robherc/Thermocouple_Board/README.md

# Thermocouple_Board
Ultra-fast, Ultra-Precise Thermocouple reading board with SPI and Analog outputs
