robherc/Thermocouple_Board/BOM/ThermocoupleBoard_BOM_1.1.xlsx

Source: | /home/robherc/Projects/RotoForge/Isolated Thermocouple Board/ThermocoupleBoard1.1/ThermocoupleBoard1.1.kicad_sch
Date: | Fri 17 Jan 2025 01:48:11 AM EST
Tool: | Eeschema 7.0.11+dfsg-1build4
Generator: | /usr/share/kicad/plugins/bom_csv_grouped_by_value_with_fp.py
Component Count: | 85
Ref | Qnty | Value | Cmp name | Footprint | Description | Part # | Vendor | Link
C1, C2 | 2 | 10u | C | Capacitor_SMD:C_0805_2012Metric | Ceramic capacitor | 1276-1096-1-ND | DigiKey | https://www.digikey.com/en/products/detail/samsung-electro-mechanics/CL21A106KOQNNNE/3886754
C3, C4 | 2 | 2u2 | C | Capacitor_SMD:C_0603_1608Metric | Ceramic capacitor | 1276-1040-1-ND | DigiKey | https://www.digikey.com/en/products/detail/samsung-electro-mechanics/CL10A225KO8NNNC/3886698
C5, C7, C9, C11, C14, C15, C16, C18, C20, C21, C23, C25, C27, C29 | 14 | 1u | C | Capacitor_SMD:C_0402_1005Metric | Ceramic capacitor | 1276-1076-1-ND | DigiKey | https://www.digikey.com/en/products/detail/samsung-electro-mechanics/CL05A105KP5NNNC/3886734
C6, C8, C10, C12, C17, C19, C22, C24, C26, C28, C30, C34 | 12 | 10n | C | Capacitor_SMD:C_0402_1005Metric | Ceramic capacitor | 490-1313-1-ND | DigiKey | https://www.digikey.com/en/products/detail/murata-electronics/GRM155R71C103KA01D/587215
C13, C35, C36 | 3 | 0u1 | C | Capacitor_SMD:C_0402_1005Metric | Ceramic capacitor | 490-6328-1-ND | DigiKey | https://www.digikey.com/en/products/detail/murata-electronics/GRM155R71C104KA88J/2610892
C33 | 1 | 0.47u | C | Capacitor_SMD:C_0402_1005Metric | Ceramic capacitor | 490-3264-1-ND | DigiKey | https://www.digikey.com/en/products/detail/murata-electronics/GRM155R61A474KE15D/702528
D1 | 1 | D_Schottky | D_Schottky | Diode_SMD:D_2010_5025Metric | Schottky barrier diode | 4878-SK14CT-ND | DigiKey | https://www.digikey.com/en/products/detail/diotec-semiconductor/SK14/13164091
D2 | 1 | D_Zener_3v0 | D_Zener | Diode_SMD:D_SOD-123 | Zener diode 3V0 | MMSZ4683-TPMSCT-ND | DigiKey | https://www.digikey.com/en/products/detail/micro-commercial-co/MMSZ4683-TP/2345537
J1 | 1 | DAC_OUT | Conn_01x01 | PinHeader_1x01_P2.54mm_Vertical | Single Header Pin | SAM1112-01-ND | DigiKey | https://www.digikey.com/en/products/detail/samtec-inc/TS-101-T-A/1105493
J2 | 1 | SPI | Conn_01x06 | PinHeader_1x06_P2.54mm_Vertical | 2.54mm 6-pin header | SAM1112-06-ND | DigiKey | https://www.digikey.com/en/products/detail/samtec-inc/TS-106-T-A/1105488
J3 | 1 | RST | Conn_01x02 | PinHeader_1x02_P2.54mm_Vertical | 2.54mm 2-pin header | SAM1112-02-ND | DigiKey | https://www.digikey.com/en/products/detail/samtec-inc/TS-102-T-A/1105492
J4 | 1 | DAC | Conn_01x03 | PinHeader_1x03_P2.54mm_Vertical | 2.54mm 3-pin header | SAM1112-03-ND | DigiKey | https://www.digikey.com/en/products/detail/samtec-inc/TS-103-T-A/1105491
J5 | 1 | SWD | Conn_01x04 | PinHeader_1x04_P2.54mm_Vertical | 2.54mm 4-pin header | SAM1112-04-ND | DigiKey | https://www.digikey.com/en/products/detail/samtec-inc/TS-104-T-A/1105490
J6 | 1 | UPDI | Conn_01x03 | PinHeader_1x03_P2.54mm_Vertical | 2.54mm 3-pin header | SAM1112-03-ND | DigiKey | https://www.digikey.com/en/products/detail/samtec-inc/TS-103-T-A/1105491
L1 | 1 | SRF0703-6R8M | SRF0703-220M | custom:0703 | 6.8uH SMPS dual-coil inductor/xfmr | SRF0703-6R8MCT-ND | DigiKey | https://www.digikey.com/en/products/detail/bourns-inc/SRF0703-6R8M/2458495
Q1 | 1 | DMN2310U | DMG2301L | Package_TO_SOT_SMD:SOT-23 | MOSFET BVDSS: 8V~24V SOT23 | 31-DMN2310U-7CT-ND | DigiKey | https://www.digikey.com/en/products/detail/diodes-incorporated/DMN2310U-7/16547521
R1 | 1 | 4R7 | R | Resistor_SMD:R_2512_6332Metric | Resistor | CR2512-J/-4R7ELF | DigiKey | https://www.digikey.com/en/products/detail/bourns-inc/CR2512-J-4R7ELF/3785984
R2 | 1 | 470R | R | Resistor_SMD:R_0402_1005Metric | Resistor | RC0402FR-07470RL | DigiKey | https://www.digikey.com/en/products/detail/yageo/RC0402FR-07470RL/726619
R3 | 1 | 10R | R | Resistor_SMD:R_1206_3216Metric | Resistor | WR12X100 JTL | DigiKey | https://www.digikey.com/en/products/detail/walsin-technology-corporation/WR12X100-JTL/13240676
R4, R5, R10, R11, R12, R13 | 6 | 1k | R | Resistor_SMD:R_0603_1608Metric | Resistor | RC0603DR-071KL | DigiKey | https://www.digikey.com/en/products/detail/yageo/RC0603DR-071KL/5917907
R6, R14, R17 | 3 | 22k | R | Resistor_SMD:R_0603_1608Metric | Resistor | RT0603DRE0722KL | DigiKey | https://www.digikey.com/en/products/detail/yageo/RT0603DRE0722KL/1074702
R7 | 1 | 470k | R | Resistor_SMD:R_0603_1608Metric | Resistor | RT0603DRE07470KL | DigiKey | https://www.digikey.com/en/products/detail/yageo/RT0603DRE07470KL/5928918
R8, R9 | 2 | 47k | R | Resistor_SMD:R_0603_1608Metric | Resistor | RC0603DR-0747KL | DigiKey | https://www.digikey.com/en/products/detail/yageo/RC0603DR-0747KL/5918084
R15, R16 | 2 | 1M | R | Resistor_SMD:R_0603_1608Metric | Resistor | 560112116074 | DigiKey | https://www.digikey.com/en/products/detail/w%C3%BCrth-elektronik/560112116074/22230634
R19 | 1 | 0R | R | Resistor_SMD:R_1206_3216Metric | Resistor | RMCF1206ZT0R00 | DigiKey | https://www.digikey.com/en/products/detail/stackpole-electronics-inc/RMCF1206ZT0R00/1756906
R20 | 1 | 10M | R | Resistor_SMD:R_0402_1005Metric | Resistor | AC0402JR-0710ML | DigiKey | https://www.digikey.com/en/products/detail/yageo/AC0402JR-0710ML/5895572
R21, R22 | 2 | 10K | R | Resistor_SMD:R_0603_1608Metric | Resistor | 560112116005 | DigiKey | https://www.digikey.com/en/products/detail/w%C3%BCrth-elektronik/560112116005/22230720
RV1 | 1 | Trim-Pot_20k | R_Potentiometer_US | custom:TRIM_TC33X-2-203E | 20k Trim-Pot | TC33X-2-203ECT-ND | DigiKey | https://www.digikey.com/en/products/detail/bourns-inc/TC33X-2-203E/2566887
RX1 | 1 | 1M | R | Resistor_SMD:R_0603_1608Metric | Resistor | 560112116074 | DigiKey | https://www.digikey.com/en/products/detail/w%C3%BCrth-elektronik/560112116074/22230634
RY1 | 1 | 1M | R | Resistor_SMD:R_0603_1608Metric | Resistor | 560112116074 | DigiKey | https://www.digikey.com/en/products/detail/w%C3%BCrth-elektronik/560112116074/22230634
Rz1, Rz2, Rz3 | 3 | 22k | R | Resistor_SMD:R_0603_1608Metric | Resistor | 560112116022 | DigiKey | https://www.digikey.com/en/products/detail/w%C3%BCrth-elektronik/560112116022/22230630
TC1 | 1 | Thermocouple | Thermocouple | custom:TypeKSocket | Thermocouple Socket | PCC-SMP-U | AliExpress | https://www.aliexpress.us/item/3256805330271859.html
TVS1 | 1 | 256V | D_TVS | custom:DO-214AA | Bidirectional TVS diode | 13-P6SMB300CA-AT/TR13CT-ND | DigiKey | https://www.digikey.com/en/products/detail/yageo/P6SMB300CA-AT-TR13/16266113
U1 | 1 | MSPM0G1507SPTR | MSPM0G1507SPTR | Package_QFP:LQFP-48_7x7mm_P0.5mm | 80MHz 32-bit ARM Mixed-Signal MCU | MSPM0G1507SPTR | DigiKey | https://www.digikey.com/en/products/detail/texas-instruments/MSPM0G1507SPTR/22147190
U2 | 1 | ATtiny1604-SS | ATtiny1604-SS | Package_SO:SOIC-14_3.9x8.7mm_P1.27mm | AtTiny1604 – 20MHz, SOIC-14 | ATTINY1604-SSNR | DigiKey | https://www.digikey.com/en/products/detail/microchip-technology/ATTINY1604-SSNR/10270297
U3 | 1 | H11L1 | H11L1 | custom:H11L1-4 | SMPS control feedback OptoIsolator | H11L1SM | DigiKey | https://www.digikey.com/en/products/detail/isocom-components-2004-ltd/H11L1SM/5036962
U4, U5 | 2 | AP2112K-3.3 | AP2112K-3.3 | Package_TO_SOT_SMD:SOT-23-5 | 600mA LDO, 3.8V-6V in, 3.3V out | AP2112K-3.3TRG1 | DigiKey | https://www.digikey.com/en/products/detail/diodes-incorporated/AP2112K-3-3TRG1/4470746
U6 | 1 | TSZ121 | TSZ121ICT | Package_TO_SOT_SMD:SOT-353_SC-70-5 | IC OPAMP ZERO DRIFT | TSZ121ICT | DigiKey | https://www.digikey.com/en/products/detail/stmicroelectronics/TSZ121ICT/3820959
U7 | 1 | MCP1501T-20E | MCP1501-10xCH | Package_TO_SOT_SMD:SOT-23-6 | 2.048V, 0.1%, 20mA, Precision Vref | MCP1501T-20E/CHY | DigiKey | https://www.digikey.com/en/products/detail/microchip-technology/MCP1501T-20E-CHY/5844606
U8 | 1 | MCP3565R | MCP3565R | custom:MCP3565 | SPI ADC 24-bit | MCP3565RT-E/SFX | DigiKey | https://www.digikey.com/en/products/detail/microchip-technology/MCP3565RT-E-SFX/13252217
U9 | 1 | ISO1640BDR | ISO6721RB | Package_SO:SOIC-8_3.9x4.9mm_P1.27mm | Bi-Directional Digital Isolator, 1.7MHz | ISO1640BDR | DigiKey | https://www.digikey.com/en/products/detail/texas-instruments/ISO1640BDR/13627078
U11 | 1 | STS40-CD1B | STS4X | custom:STS4X | I2C Temperature Sensor | STS40-CD1B-R3 | DigiKey | https://www.digikey.com/en/products/detail/sensirion-ag/STS40-CD1B-R3/16021180
JP1 | 2 | Shorting Jumper | Shorting Jumper | N/A | 2.54mm Header-pins Jumper | QPC02SXGN-RC | DigiKey | https://www.digikey.com/en/products/detail/sullins-connector-solutions/QPC02SXGN-RC/2618262
