robherc/Thermocouple_Board/PCB/Thermocouple_Board.kicad_pcb

## KiCad design PCB/Thermocouple_Board.kicad_pcb (2025-03-31)

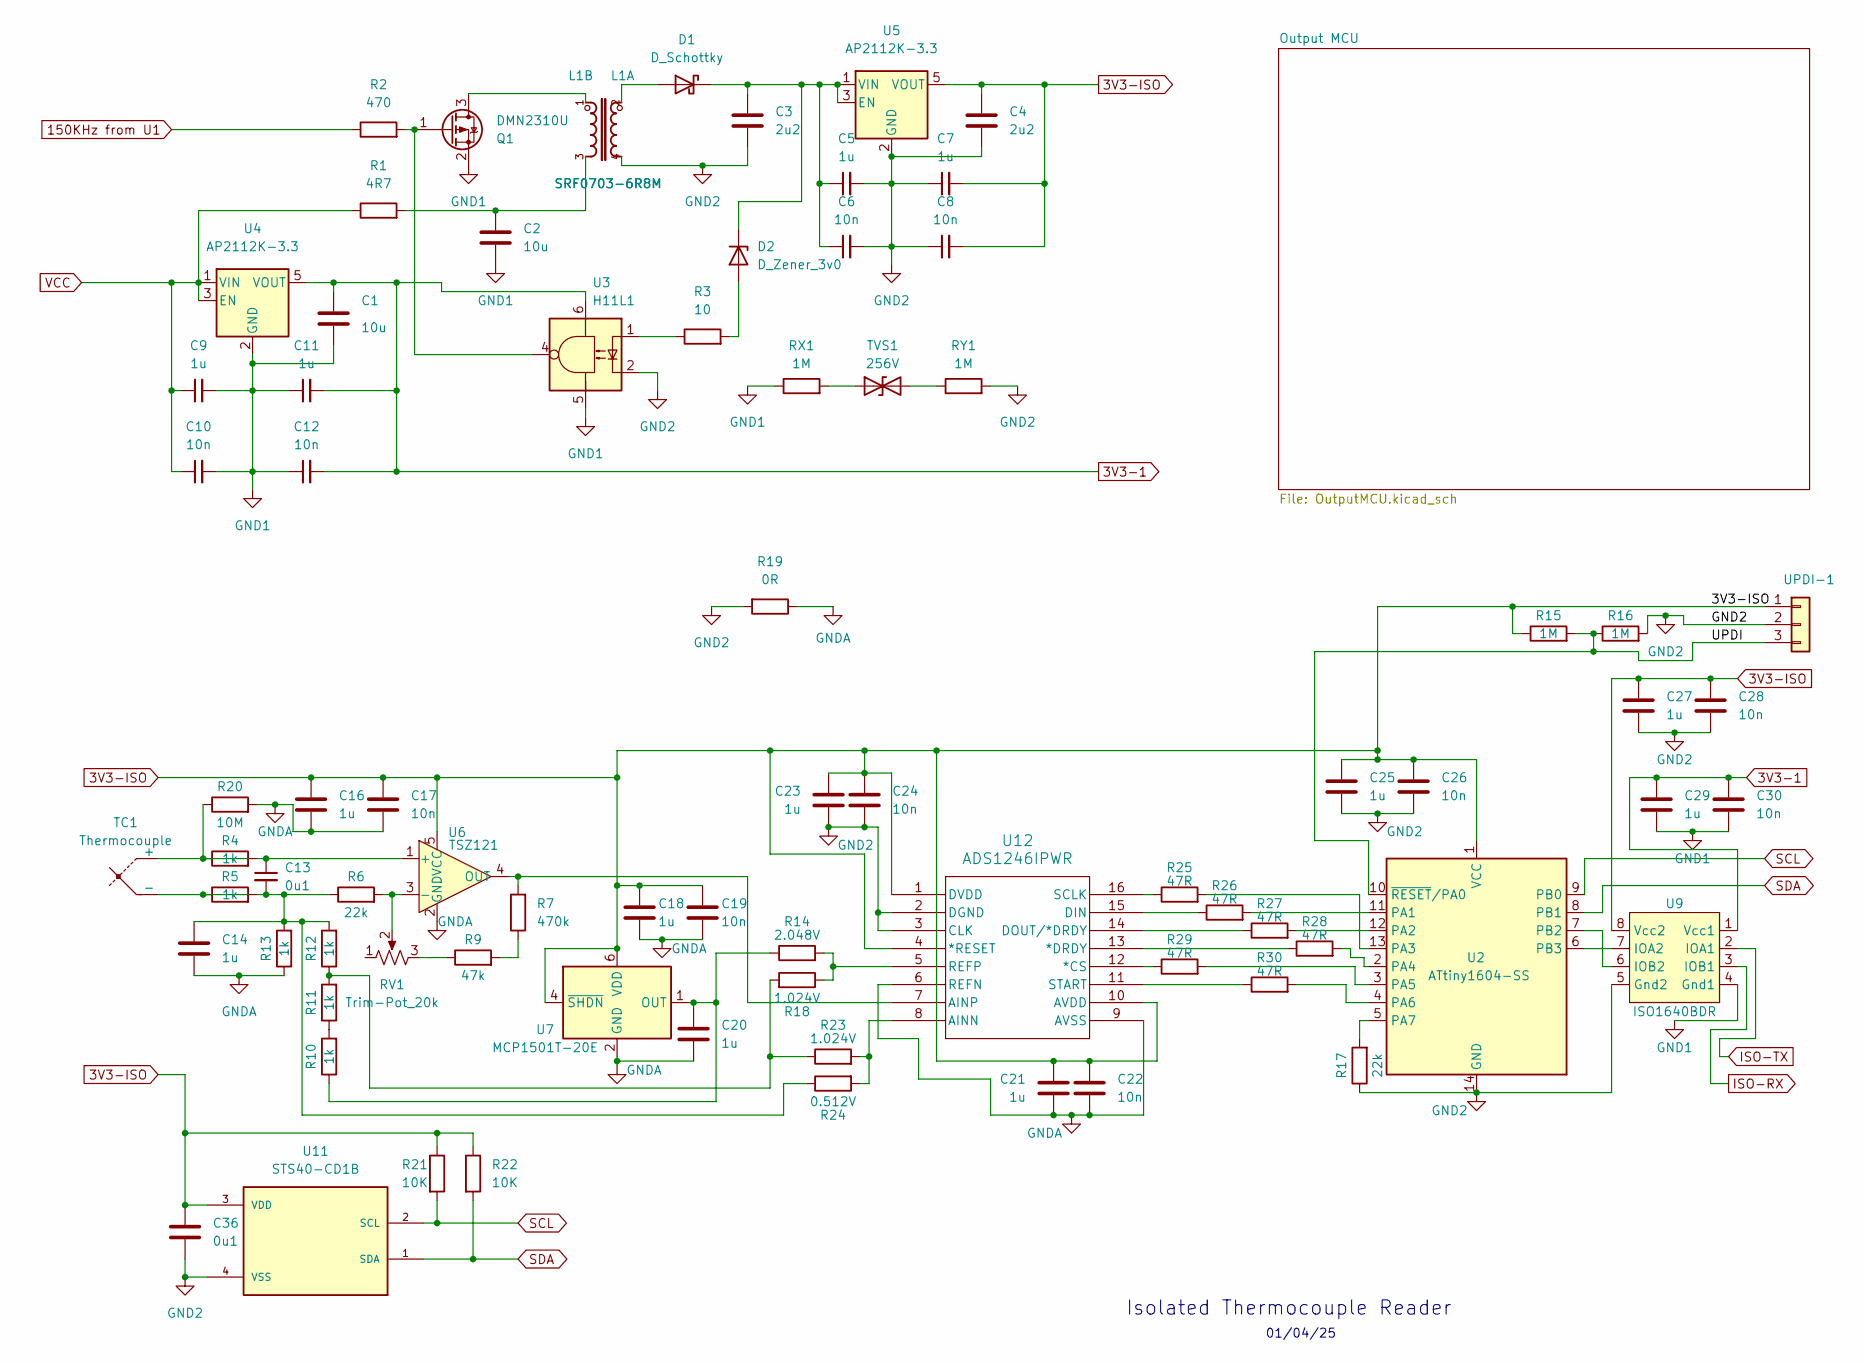
[picture p1: schematic Thermocouple_Board.kicad_sch]

Parts:
C1, C2: 10u; C_0805_2012Metric_Pad1.18x1.45mm_HandSolder
C3, C4: 2u2; C_0603_1608Metric
C5, C7, C9, C11, C14, C16, C18, C20, C21, C23, C25, C27, C29: 1u; C_0402_1005Metric
C6, C8, C10, C12, C17, C19, C22, C24, C26, C28, C30: 10n; C_0402_1005Metric
C13, C36: 0u1; C_0402_1005Metric
D1: D_Schottky; D_2010_5025Metric_Pad1.52x2.65mm_HandSolder
D2: D_Zener_3v0; D_SOD-123
J6: UPDI-1; PinHeader_1x03_P2.54mm_Vertical
L1: SRF0703-6R8M; 0703; MPN SRF0703-220M
Q1: DMN2310U; SOT-23
R1: 4R7; R_2512_6332Metric
R2: 470; R_0402_1005Metric
R3: 10; R_1206_3216Metric
R4, R5, R10, R11, R12, R13: 1k; R_0603_1608Metric
R6, R17: 22k; R_0603_1608Metric
R7: 470k; R_0603_1608Metric
R9: 47k; R_0603_1608Metric
R14: 2.048V; R_0402_1005Metric_Pad0.72x0.64mm_HandSolder
R15, R16: 1M; R_0603_1608Metric
R18, R23: 1.024V; R_0402_1005Metric_Pad0.72x0.64mm_HandSolder
R19: 0R; R_1206_3216Metric_Pad1.30x1.75mm_HandSolder
R20: 10M; R_0402_1005Metric
R21, R22: 10K; R_0603_1608Metric
R24: 0.512V; R_0402_1005Metric_Pad0.72x0.64mm_HandSolder
R25, R26, R27, R28, R29, R30: 47R; R_0603_1608Metric
RV1: Trim-Pot_20k; TRIM_TC33X-2-203E
RX1: 1M; R_0603_1608Metric
RY1: 1M; R_0603_1608Metric
TC1: Thermocouple; TypeKSocket
TVS1: 256V; DO-214AA
U2: ATtiny1604-SS; SOIC-14_3.9x8.7mm_P1.27mm
U3: H11L1; H11L1-4
U4, U5: AP2112K-3.3; SOT-23-5
U6: TSZ121; SOT-353_SC-70-5
U7: MCP1501T-20E; SOT-23-6
U9: ISO1640BDR; SOIC-8_3.9x4.9mm_P1.27mm
U11: STS40-CD1B; STS4X
U12: ADS1246IPWR; PW16

Connections:
3V3-1: C1.1, C11.2, C12.2, C29.1, C30.1, U3.6, U4.5 (VOUT), U9.1 (Vcc1); also elsewhere on the board
3V3-ISO: C4.1, C7.2, C8.2, C16.1, C17.1, C18.1, C19.1, C21.1, C22.1, C23.1, C24.1, C25.1, C26.1, C27.1, C28.1, C36.1, J6.1, R15.1, R21.1, R22.1, U2.1 (VCC), U5.5 (VOUT), U6.5 (VCC), U7.4 (~SHDN), U7.6 (VDD), U9.8 (Vcc2), U11.3 (VDD), U12.1 (DVDD), U12.4 (*RESET), U12.10 (AVDD)
150KHz from U1: R2.1; also elsewhere on the board
/UPDI: J6.3, R15.2, R16.1, U2.10 (~RESET/PA0)
GND1: C1.2, C2.2, C9.2, C10.2, C11.1, C12.1, C29.2, C30.2, Q1.2 (S), RX1.1, U3.5, U4.2 (GND), U4.4 (NC), U9.4 (Gnd1); also elsewhere on the board
GND2: C3.2, C4.2, C5.2, C6.2, C7.1, C8.1, C23.2, C24.2, C25.2, C26.2, C27.2, C28.2, C36.2, J6.2, L1.4, R16.2, R17.1, R19.2, RY1.2, U2.14 (GND), U3.2, U3.3, U5.2 (GND), U5.4 (NC), U9.5 (Gnd2), U11.4 (VSS), U12.2 (DGND), U12.3 (CLK)
GNDA: C14.2, C16.2, C17.2, C18.2, C19.2, C20.2, C21.2, C22.2, R13.1, R19.1, R20.2, U6.2 (GND), U7.2 (GND), U7.3 (GND), U7.5 (GND), U12.6 (REFN), U12.9 (AVSS)
ISO-RX: U9.3 (IOB1); also elsewhere on the board
ISO-TX: U9.2 (IOA1); also elsewhere on the board
unnamed: C2.1, L1.3, R1.2
unnamed: C13.2, C14.1, R5.2, R6.1, R12.2, R13.2, R24.1
unnamed: D1.2 (A), L1.2
unnamed: C3.1, C5.1, C6.1, D1.1 (K), D2.1 (K), U5.1 (VIN), U5.3 (EN)
unnamed: D2.2 (A), R3.2
unnamed: L1.1, Q1.3 (D)
unnamed: Q1.1 (G), R2.2, U3.4
unnamed: R3.1, U3.1
unnamed: R7.1, R9.2
unnamed: R9.1, RV1.3
unnamed: R10.2, R11.1
unnamed: R11.2, R12.1, R18.2, R23.1
unnamed: R4.1, R20.1, TC1.1 (+)
unnamed: R5.1, TC1.2 (-)
unnamed: RX1.2, TVS1.1 (A1)
unnamed: RY1.1, TVS1.2 (A2)
unnamed: R26.2, U2.11 (PA1)
unnamed: R27.2, U2.12 (PA2)
unnamed: R25.2, U2.13 (PA3)
unnamed: R28.2, U2.2 (PA4)
unnamed: R29.2, U2.3 (PA5)
unnamed: R30.2, U2.4 (PA6)
unnamed: R17.2, U2.5 (PA7)
unnamed: U2.7 (PB2), U9.6 (IOB2)
unnamed: U2.6 (PB3), U9.7 (IOA2)
unnamed: C13.1, R4.2, U6.1 (+)
unnamed: R6.2, RV1.2, U6.3 (-)
unnamed: C20.1, R10.1, R14.1, U7.1 (OUT)
unnamed: R29.1, U12.12 (*CS)
unnamed: R28.1, U12.13 (*DRDY)
unnamed: R23.2, R24.2, U12.8 (AINN)
unnamed: R7.2, U6.4 (OUT), U12.7 (AINP)
unnamed: R26.1, U12.15 (DIN)
unnamed: R27.1, U12.14 (DOUT/*DRDY)
unnamed: R14.2, R18.1, U12.5 (REFP)
unnamed: R25.1, U12.16 (SCLK)
unnamed: R30.1, U12.11 (START)
SCL: R21.2, U2.9 (PB0), U11.2 (SCL)
SDA: R22.2, U2.8 (PB1), U11.1 (SDA)
VCC: C9.1, C10.1, R1.1, U4.1 (VIN), U4.3 (EN); also elsewhere on the board

Notes on the sheet:
Isolated Thermocouple Reader
01/04/25

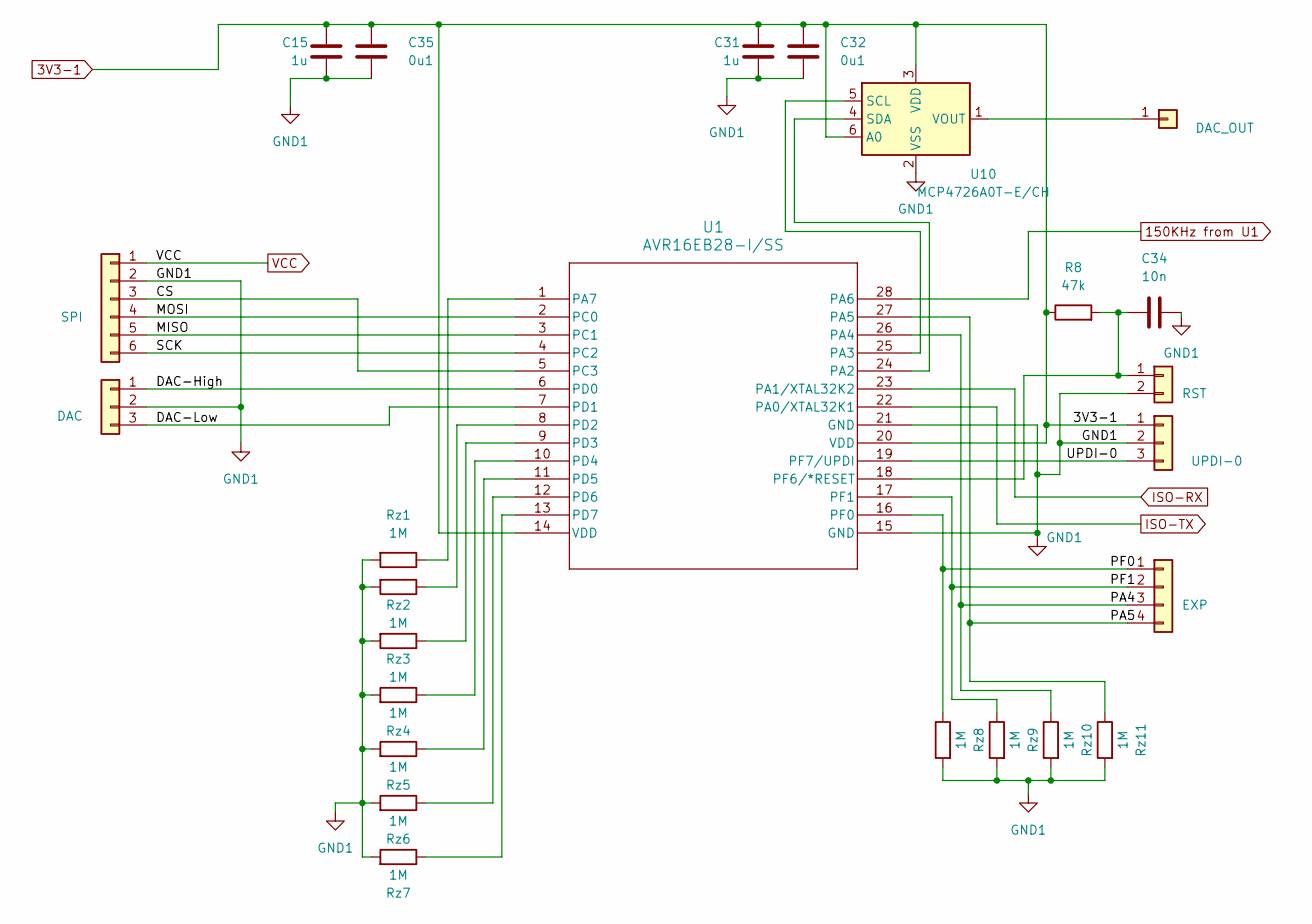
[picture p2: schematic OutputMCU.kicad_sch]

Parts:
C15, C31: 1u; C_0402_1005Metric
C32, C35: 0u1; C_0402_1005Metric
C34: 10n; C_0402_1005Metric
J1: DAC_OUT; PinHeader_1x01_P2.54mm_Vertical
J2: SPI; PinHeader_1x06_P2.54mm_Vertical
J3: RST; PinHeader_1x02_P2.54mm_Vertical
J4: DAC; PinHeader_1x03_P2.54mm_Vertical
J5: UPDI-0; PinHeader_1x03_P2.54mm_Vertical
J7: EXP; PinHeader_1x04_P2.54mm_Vertical
R8: 47k; R_0603_1608Metric
Rz1, Rz2, Rz3, Rz4, Rz5, Rz6, Rz7, Rz8, Rz9, Rz10, Rz11: 1M; R_0603_1608Metric
U1: AVR16EB28-I/SS; SSOP28_SS_MCH
U10: MCP4726A0T-E/CH; SOT-23-6

Connections:
3V3-1: C15.1, C31.1, C32.1, C35.1, J5.1, R8.1, U1.14 (VDD), U1.20 (VDD), U10.3 (VDD), U10.6 (A0); also elsewhere on the board
150KHz from U1: U1.28 (PA6); also elsewhere on the board
/Output MCU/CS: J2.3, U1.5 (PC3)
/Output MCU/DAC-High: J4.1, U1.6 (PD0)
/Output MCU/DAC-Low: J4.3, U1.7 (PD1)
/Output MCU/MISO: J2.5, U1.3 (PC1)
/Output MCU/MOSI: J2.4, U1.2 (PC0)
/Output MCU/PA4: J7.3, Rz10.1, U1.26 (PA4)
/Output MCU/PA5: J7.4, Rz11.1, U1.27 (PA5)
/Output MCU/PF0: J7.1, Rz8.1, U1.16 (PF0)
/Output MCU/PF1: J7.2, Rz9.1, U1.17 (PF1)
/Output MCU/SCK: J2.6, U1.4 (PC2)
/Output MCU/UPDI-0: J5.3, U1.19 (PF7/UPDI)
GND1: C15.2, C31.2, C32.2, C34.1, C35.2, J2.2, J3.2, J4.2, J5.2, Rz1.2, Rz2.2, Rz3.2, Rz4.2, Rz5.2, Rz6.2, Rz7.2, Rz8.2, Rz9.2, Rz10.2, Rz11.2, U1.15 (GND), U1.21 (GND), U10.2 (VSS); also elsewhere on the board
ISO-RX: U1.23 (PA1/XTAL32K2); also elsewhere on the board
ISO-TX: U1.22 (PA0/XTAL32K1); also elsewhere on the board
unnamed: J1.1, U10.1 (VOUT)
unnamed: C34.2, J3.1, R8.2, U1.18 (PF6/*RESET)
unnamed: U1.24 (PA2), U10.4 (SDA)
unnamed: U1.25 (PA3), U10.5 (SCL)
unnamed: Rz1.1, U1.1 (PA7)
unnamed: Rz2.1, U1.8 (PD2)
unnamed: Rz3.1, U1.9 (PD3)
unnamed: Rz4.1, U1.10 (PD4)
unnamed: Rz5.1, U1.11 (PD5)
unnamed: Rz6.1, U1.12 (PD6)
unnamed: Rz7.1, U1.13 (PD7)
VCC: J2.1; also elsewhere on the board

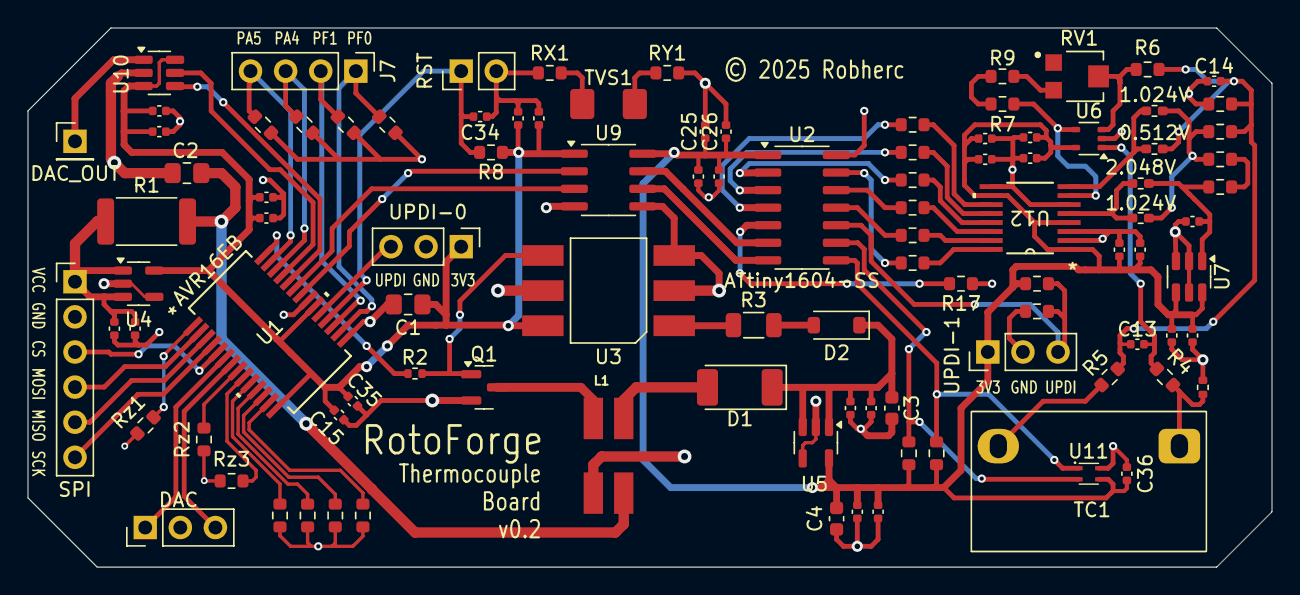
[picture p3: board Thermocouple_Board.kicad_pcb from above]

Board: 2 copper layers, 90.0 x 39.0 mm, 103 parts (1 on the bottom side), 71 nets.
