robherc/Thermocouple_Board/PCB/ThermocoupleBoard.kicad_pcb

## KiCad design PCB/ThermocoupleBoard.kicad_pcb (2025-01-19)

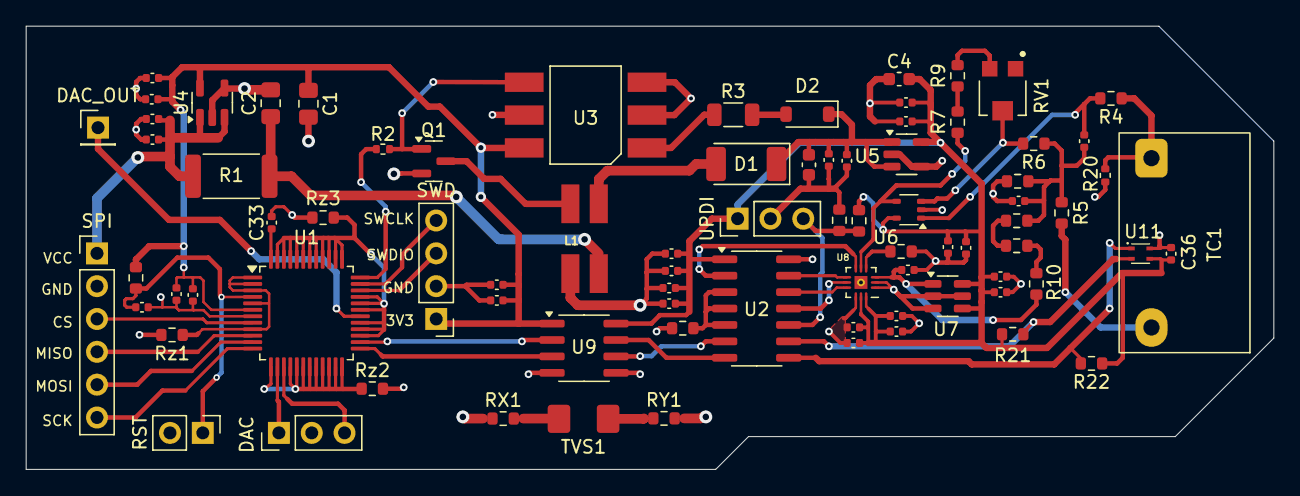
[picture p4: board ThermocoupleBoard.kicad_pcb from above]

Board: 2 copper layers, 96.5 x 34.3 mm, 83 parts (1 on the bottom side), 54 nets.

Parts:
C1, C2: 10u; C_0805_2012Metric_Pad1.18x1.45mm_HandSolder
C3, C4: 2u2; C_0603_1608Metric
C5, C7, C9, C11, C14, C15, C16, C18, C20, C21, C23, C25, C27, C29: 1u; C_0402_1005Metric
C6, C8, C10, C12, C17, C19, C22, C24, C26, C28, C30, C34: 10n; C_0402_1005Metric
C13, C35, C36: 0u1; C_0402_1005Metric
C33: 0.47u; C_0402_1005Metric
D1: D_Schottky; D_2010_5025Metric_Pad1.52x2.65mm_HandSolder
D2: D_Zener_3v0; D_SOD-123
J1: DAC_OUT; PinHeader_1x01_P2.54mm_Vertical
J2: SPI; PinHeader_1x06_P2.54mm_Vertical
J3: RST; PinHeader_1x02_P2.54mm_Vertical
J4: DAC; PinHeader_1x03_P2.54mm_Vertical
J5: SWD; PinHeader_1x04_P2.54mm_Vertical
J6: UPDI; PinHeader_1x03_P2.54mm_Vertical
L1: 22uH; 0703
Q1: DMN2310U; SOT-23
R1: 4R7; R_2512_6332Metric
R2: 470; R_0402_1005Metric
R3: 10; R_1206_3216Metric
R4, R5, R10, R11, R12, R13: 1k; R_0603_1608Metric
R6, R14, R17: 22k; R_0603_1608Metric
R7: 470k; R_0603_1608Metric
R8, R9: 47k; R_0603_1608Metric
R15, R16: 1M; R_0603_1608Metric
R19: 0R; R_1206_3216Metric_Pad1.30x1.75mm_HandSolder
R20: 10M; R_0402_1005Metric
R21, R22: 10K; R_0603_1608Metric
RV1: Trim-Pot_20k; TRIM_TC33X-2-203E
RX1: 1M; R_0603_1608Metric
RY1: 1M; R_0603_1608Metric
Rz1, Rz2, Rz3: 22k; R_0603_1608Metric
TC1: Thermocouple; TypeKSocket
TVS1: 256V; DO-214AA
U1: MSPM0G1507SPTR; LQFP-48_7x7mm_P0.5mm
U2: ATtiny1604-SS; SOIC-14_3.9x8.7mm_P1.27mm
U3: H11L1; H11L1-4
U4, U5: AP2112K-3.3; SOT-23-5
U6: TSZ121; SOT-353_SC-70-5
U7: MCP1501T-20E; SOT-23-6
U8: MCP3565R; MCP3565
U9: ISO1640BDR; SOIC-8_3.9x4.9mm_P1.27mm
U11: STS40-CD1B; STS4X

Connections:
3V3-1: C1.1, C11.2, C12.2, C15.1, C29.1, C30.1, C35.1, J5.1, R8.1, U1.6 (VDD), U3.6, U4.5 (VOUT), U9.1 (Vcc1)
3V3-ISO: C4.1, C7.2, C8.2, C16.1, C17.1, C18.1, C19.1, C21.1, C22.1, C23.1, C24.1, C25.1, C26.1, C27.1, C28.1, C36.1, J6.1, R15.1, R21.1, R22.1, U2.1 (VCC), U5.5 (VOUT), U6.5 (VCC), U7.4 (~SHDN), U7.6 (VDD), U8.11 (Dvdd), U8.12 (Avdd), U9.8 (Vcc2), U11.3 (VDD)
150KHz from U1: R2.1, U1.36 (PB17_A1_4)
/Output MCU/CS: J2.3, U1.8 (PA2_ROSC)
/Output MCU/DAC-High: J4.1, U1.14 (PB2)
/Output MCU/DAC-Low: J4.3, U1.15 (PB3)
/Output MCU/MISO: J2.4, U1.10 (PA4_LFXOUT)
/Output MCU/MOSI: J2.5, U1.11 (PA5_HFXIN)
/Output MCU/SCK: J2.6, U1.12 (PA6_HFXOUT)
/Output MCU/SWCLK: J5.4, U1.35 (PA20_SWCLK)
/Output MCU/SWDIO: J5.3, U1.34 (PA19_SWDIO)
/UPDI: J6.3, R15.2, R16.1, U2.10 (~RESET/PA0)
GND1: C1.2, C2.2, C9.2, C10.2, C11.1, C12.1, C15.2, C29.2, C30.2, C33.2, C34.2, C35.2, J2.2, J3.2, J4.2, J5.2, Q1.2 (S), RX1.1, Rz1.2, Rz2.2, Rz3.2, U1.7 (VSS), U3.5, U4.2 (GND), U4.4 (NC), U9.4 (Gnd1)
GND2: C3.2, C4.2, C5.2, C6.2, C7.1, C8.1, C23.2, C24.2, C25.2, C26.2, C27.2, C28.2, C36.2, J6.2, L1.4, R16.2, R17.1, R19.2, RY1.2, U2.14 (GND), U3.2, U3.3, U5.2 (GND), U5.4 (NC), U8.10 (Dgnd), U9.5 (Gnd2), U11.4 (VSS)
GNDA: C14.2, C16.2, C17.2, C18.2, C19.2, C20.2, C21.2, C22.2, R13.1, R14.1, R19.1, R20.2, U6.2 (GND), U7.2 (GND), U7.3 (GND), U7.5 (GND), U8.1 (Agnd), U8.2 (Aref-), U8.13 (PAD)
ISO-MISO: U1.25 (PB15), U9.3 (IOB1)
ISO-MOSI: U1.26 (PB16), U9.2 (IOA1)
unnamed: C2.1, L1.3, R1.2
unnamed: C13.2, C14.1, R5.2, R6.1, R12.2, R13.2
unnamed: D1.2 (A), L1.2
unnamed: C3.1, C5.1, C6.1, D1.1 (K), D2.1 (K), U5.1 (VIN), U5.3 (EN)
unnamed: D2.2 (A), R3.2
unnamed: J1.1, U1.30 (PA15_A1_0)
unnamed: C34.1, J3.1, R8.2, U1.4 (RST_N)
unnamed: L1.1, Q1.3 (D)
unnamed: Q1.1 (G), R2.2, U3.4
unnamed: R3.1, U3.1
unnamed: R7.1, R9.2
unnamed: R9.1, RV1.3
unnamed: R10.2, R11.1
unnamed: R11.2, R12.1
unnamed: R4.1, R20.1, TC1.1 (+)
unnamed: R5.1, TC1.2 (-)
unnamed: RX1.2, TVS1.1 (A1)
unnamed: RY1.1, TVS1.2 (A2)
unnamed: Rz1.1, U1.1 (PA0), U1.2 (PA1), U1.3 (PA28), U1.5 (PA31), U1.9 (PA3_LFXIN)
unnamed: Rz2.1, U1.13 (PA7), U1.16 (PA8), U1.17 (PA9), U1.18 (PA10), U1.19 (PA11), U1.20 (PB6), U1.21 (PB7), U1.22 (PB8), U1.23 (PB9), U1.24 (PB14)
unnamed: Rz3.1, U1.27 (PA12), U1.28 (PA13), U1.29 (PA14), U1.31 (PA16_A1_1), U1.32 (PA17_A1_2), U1.33 (PA18_A1_3), U1.37 (PB18_A1_5), U1.38 (PB19_A1_6), U1.39 (PA21_A1_7_VREF-), U1.40 (PA22_A0_7), U1.41 (PB20_A0_6), U1.42 (PB24_A0_5), U1.43 (PA23_VREF+), U1.44 (PA24_A0_3), U1.45 (PA25_A0_2), U1.46 (PA26_A0_1), U1.47 (PA27_A0_0)
unnamed: C33.1, U1.48 (VCORE)
unnamed: U2.11 (PA1), U8.8 (MOSI)
unnamed: U2.12 (PA2), U8.9 (MISO)
unnamed: U2.13 (PA3), U8.7 (SCK)
unnamed: U2.2 (PA4), U8.6 (CS)
unnamed: R17.2, U2.3 (PA5), U2.4 (PA6), U2.5 (PA7)
unnamed: U2.7 (PB2), U9.7 (IOA2)
unnamed: U2.6 (PB3), U9.6 (IOB2)
unnamed: C13.1, R4.2, U6.1 (+)
unnamed: R6.2, RV1.2, U6.3 (-)
unnamed: R7.2, U6.4 (OUT), U8.5 (CH0)
unnamed: C20.1, R10.1, U7.1 (OUT), U8.3 (Aref+)
unnamed: R14.2, U8.4 (CH1)
SCL: R21.2, U2.9 (PB0), U11.2 (SCL)
SDA: R22.2, U2.8 (PB1), U11.1 (SDA)
VCC: C9.1, C10.1, J2.1, R1.1, U4.1 (VIN), U4.3 (EN)
