robherc/Thermocouple_Board/(threads)

Thread 1 (2025-04-30):

Resistor Value for R13,R14,R23 and R24

Rubines, 2025-04-30:
Hi

Thank <ou for sharing this interesting project.
I dont understand tough, what are the values for the resistors R13,R14,R23 and R24, in the schemativ there is a voltage value instead of the resistor

robherc, 2025-05-25:
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

Those resistors are placeholders for solder-bridge jumpers to set the voltage-levels for the weirdo-TI ADC (which incidentally none of thd chips I've tested actually work at all...so I'm working to find a replacement ADC chip for Rev.C of the board (which will __hopefully__ be the first fully-functional version)
