robherc/Thermocouple_Board/(commit log)

2025-01-19 Original Commit
    [OutputMCU.kicad_sch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]
2025-03-02 Added board prototype v0.2 featuring 2 AVR MCUs
    [OutputMCU.kicad_sch, Thermocouple_Board_AVRx2.kicad_pcb, Thermocouple_Board_AVRx2.kicad_sch]
2025-03-02 Fix Typo
    [Thermocouple_Board_AVRx2.kicad_pcb]
2025-03-04 Update pcb designs to further optimize layout, fix an error, and creat prototype layout with test points
    [Thermocouple_Board_AVRx2.PROTO.kicad_pcb]
2025-03-18 Added a second test program to mirror UART to MISO+MOSI for step 2 testing, added a reference & added some code organization
2025-03-19 Fix a couple of switched traces
    [OutputMCU.kicad_sch, Thermocouple_Board_AVRx2.PROTO.kicad_pcb, Thermocouple_Board_AVRx2.kicad_sch]
2025-03-19 add combined SMPS & UART transparent passthrough test code
2025-03-20 Fix crossed traces that were found during prototype testing
    [OutputMCU.kicad_sch, Thermocouple_Board_AVRx2.PROTO.kicad_pcb, Thermocouple_Board_AVRx2.kicad_pcb, Thermocouple_Board_AVRx2.kicad_sch]
2025-03-21 Add testing code for the 24-bit ADC
2025-03-21 New ADC-only testing code
2025-03-21 Fixed issues with example ADC code
    [ADCUART-Dump.ino]
2025-03-31 update to latest kicad version
    [OutputMCU.kicad_sch, Thermocouple_Board_AVRx2.PROTO.kicad_pcb, Thermocouple_Board_AVRx2.kicad_pcb, Thermocouple_Board_AVRx2.kicad_sch]
2025-04-01 Remove files from obsolete RevA, in preparation for RevC progress.
    [OutputMCU.kicad_sch, Thermocouple_Board.PROTO.kicad_pcb, Thermocouple_Board.kicad_pcb, Thermocouple_Board.kicad_sch]
2025-04-01 garbage collection
    [OutputMCU.kicad_sch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]
