robherc/Thermocouple_Board/(notices)

Notices in the files:
PCB/Thermocouple_Board.kicad_pcb:
© 2025 Robherc
